UoM-AAS-CanSat-2023-24/FLIGHT_HARDWARE_2025/Graphics/mind-the-gap.jpg

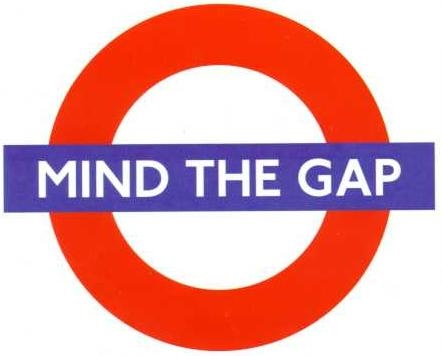
Graphics/mind-the-gap.jpg
