UoM-AAS-CanSat-2023-24/FLIGHT_HARDWARE_2025/Graphics/fry/LFT8uoP.jpeg

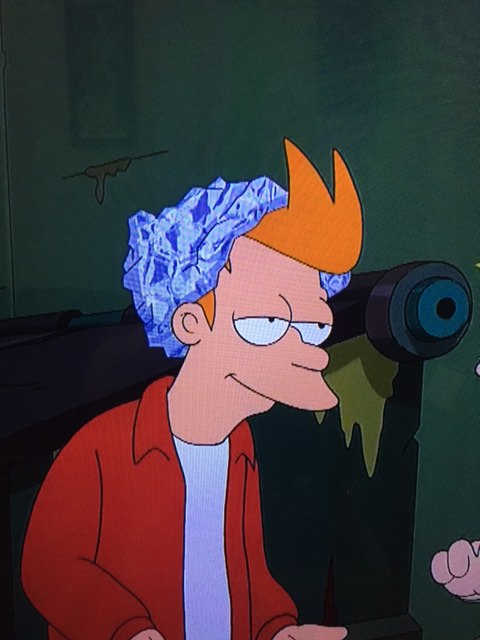
Graphics/fry/LFT8uoP.jpeg
