UoM-AAS-CanSat-2023-24/FLIGHT_HARDWARE_2025/Graphics/cow.jpeg

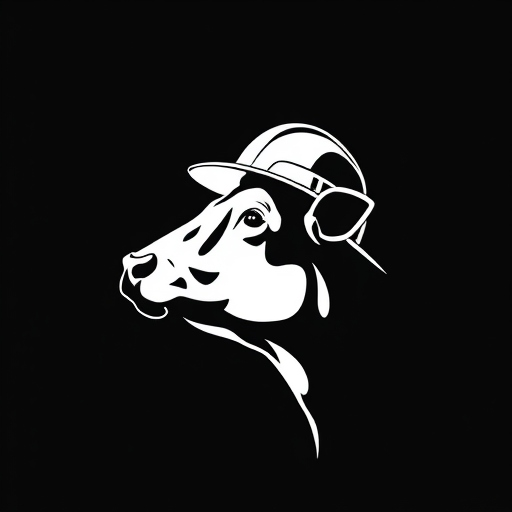
Graphics/cow.jpeg
