UoM-AAS-CanSat-2023-24/FLIGHT_HARDWARE_2025/Graphics/el_presidente.jpg

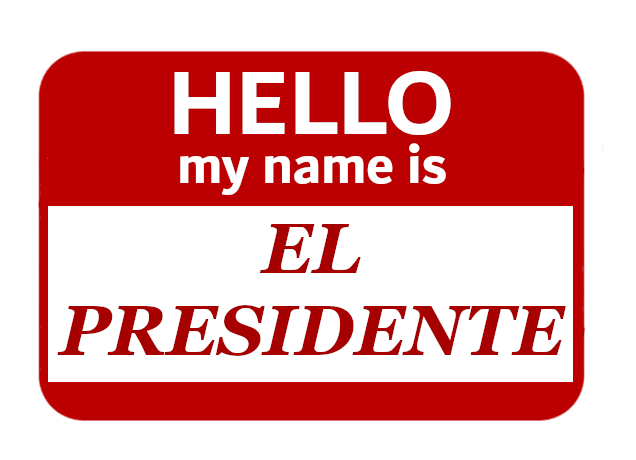
Graphics/el_presidente.jpg
