UoM-AAS-CanSat-2023-24/FLIGHT_HARDWARE_2025/Graphics/fry/hat.jpg

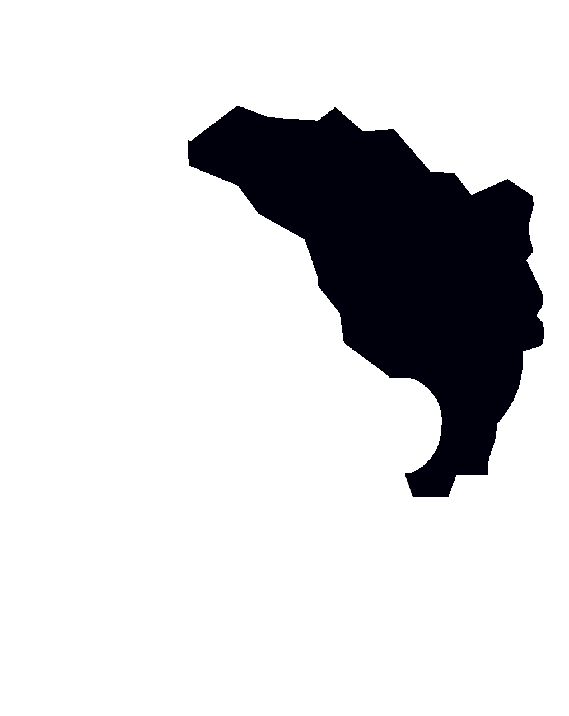
Graphics/fry/hat.jpg
