UoM-AAS-CanSat-2023-24/FLIGHT_HARDWARE_2025/Graphics/fry/hat_flipped.jpg

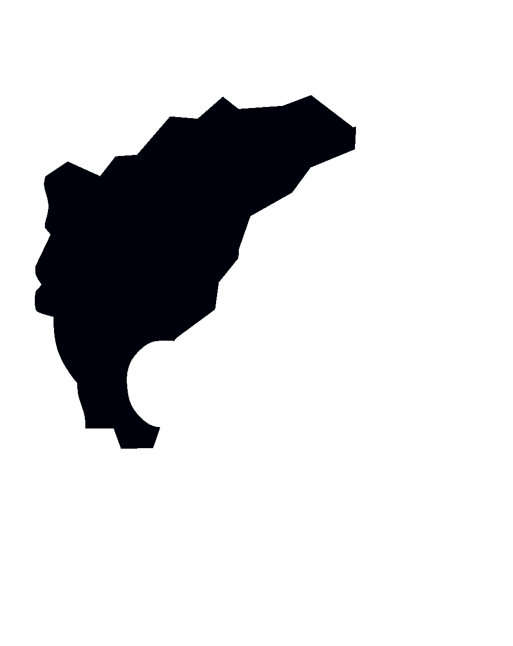
Graphics/fry/hat_flipped.jpg
