UoM-AAS-CanSat-2023-24/FLIGHT_HARDWARE_2025/Graphics/fry/outline_flipped.jpg

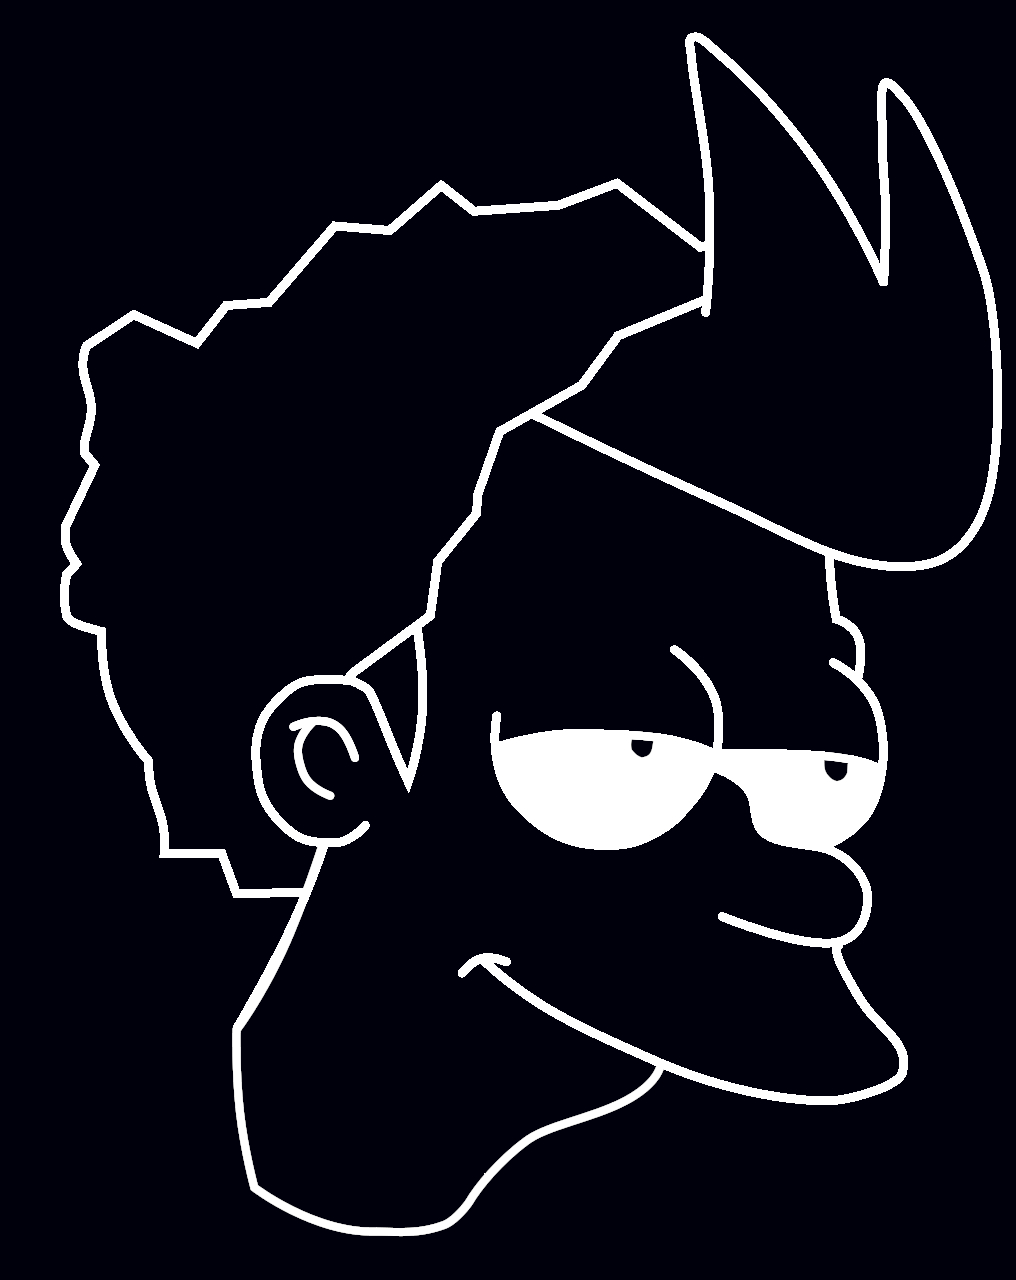
Graphics/fry/outline_flipped.jpg
