UoM-AAS-CanSat-2023-24/FLIGHT_HARDWARE_2025/Graphics/Ikea/ikea_screw.jpg

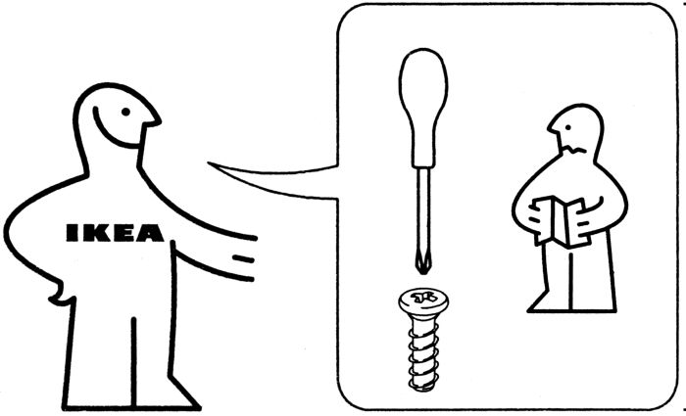
Graphics/Ikea/ikea_screw.jpg
