UoM-AAS-CanSat-2023-24/FLIGHT_HARDWARE_2025/Graphics/Ikea/man.jpg

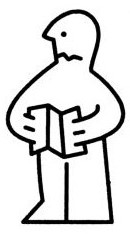
Graphics/Ikea/man.jpg
