UoM-AAS-CanSat-2023-24/FLIGHT_HARDWARE_2025/Graphics/M2269 UoM Bee graphic/UoM Bee 1 colour 50%black/UoM Bee 1 colour 50%black.png

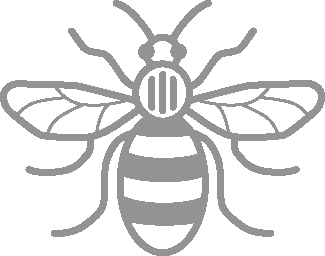
Graphics/M2269 UoM Bee graphic/UoM Bee 1 colour 50%black/UoM Bee 1 colour 50%black.png
