UoM-AAS-CanSat-2023-24/FLIGHT_HARDWARE_2025/Graphics/M2269 UoM Bee graphic/UoM Bee 1 colour white/UoM Bee 1 colour white.png

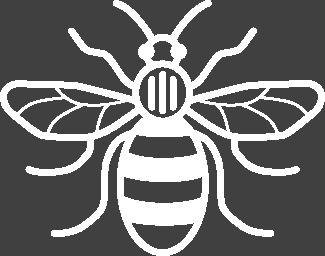
Graphics/M2269 UoM Bee graphic/UoM Bee 1 colour white/UoM Bee 1 colour white.png
