UoM-AAS-CanSat-2023-24/FLIGHT_HARDWARE_2025/Graphics/moses.jpeg

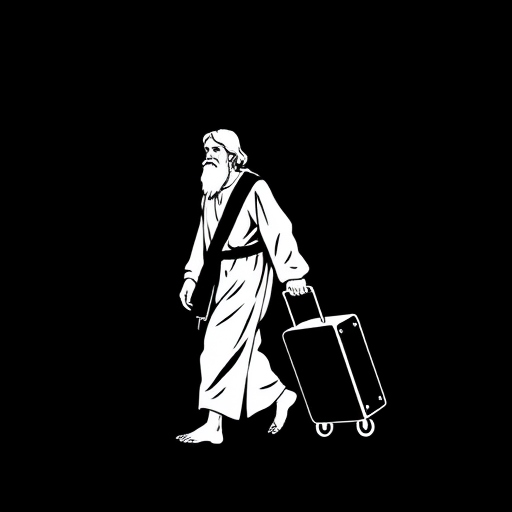
Graphics/moses.jpeg
