UoM-AAS-CanSat-2023-24/FLIGHT_HARDWARE_2025/Graphics/mugshot/option1_lens.jpg

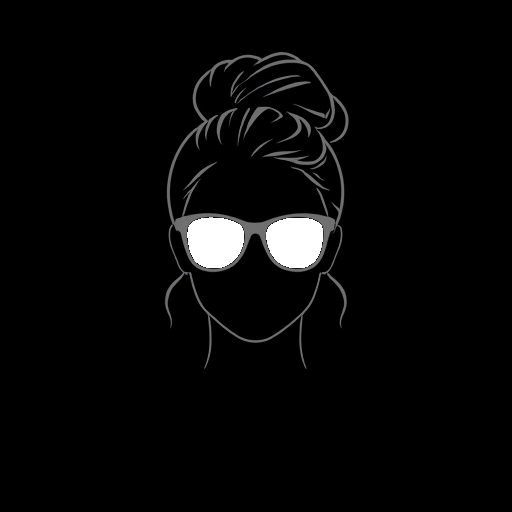
Graphics/mugshot/option1_lens.jpg
