UoM-AAS-CanSat-2023-24/FLIGHT_HARDWARE_2025/Graphics/name_tag.jpg

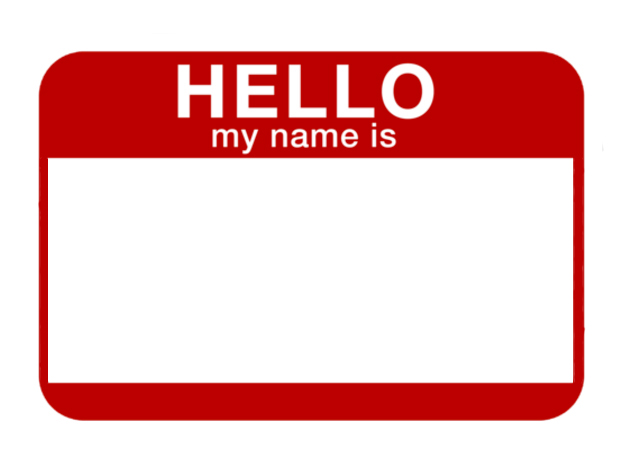
Graphics/name_tag.jpg
