UoM-AAS-CanSat-2023-24/FLIGHT_HARDWARE_2025/Graphics/Names_caps.png

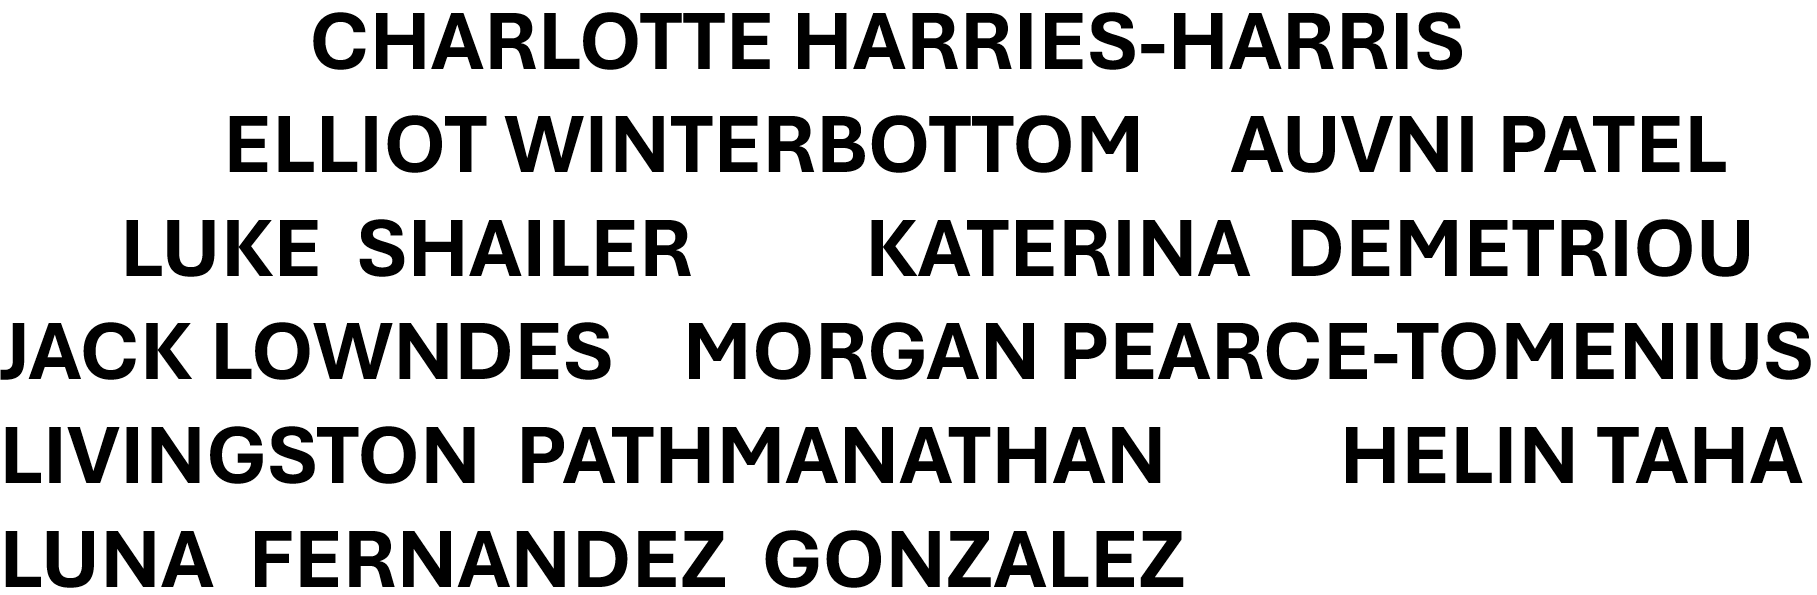
Graphics/Names_caps.png
