UoM-AAS-CanSat-2023-24/FLIGHT_HARDWARE_2025/Graphics/pepsi/6b5bf94c-5b68-4c5f-819d-e98600e77a42.jpeg

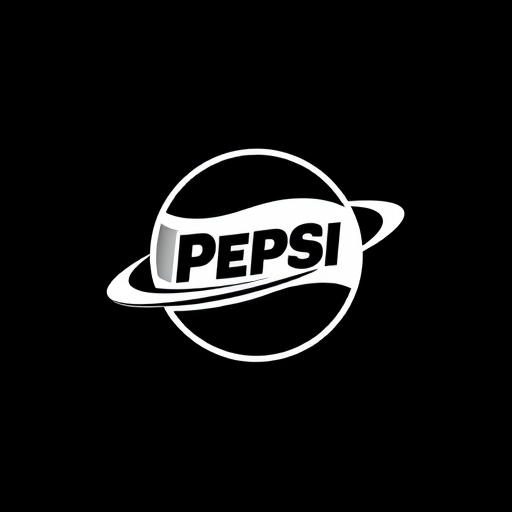
Graphics/pepsi/6b5bf94c-5b68-4c5f-819d-e98600e77a42.jpeg
