UoM-AAS-CanSat-2023-24/FLIGHT_HARDWARE_2025/Graphics/pepsi/pepsi_can.png

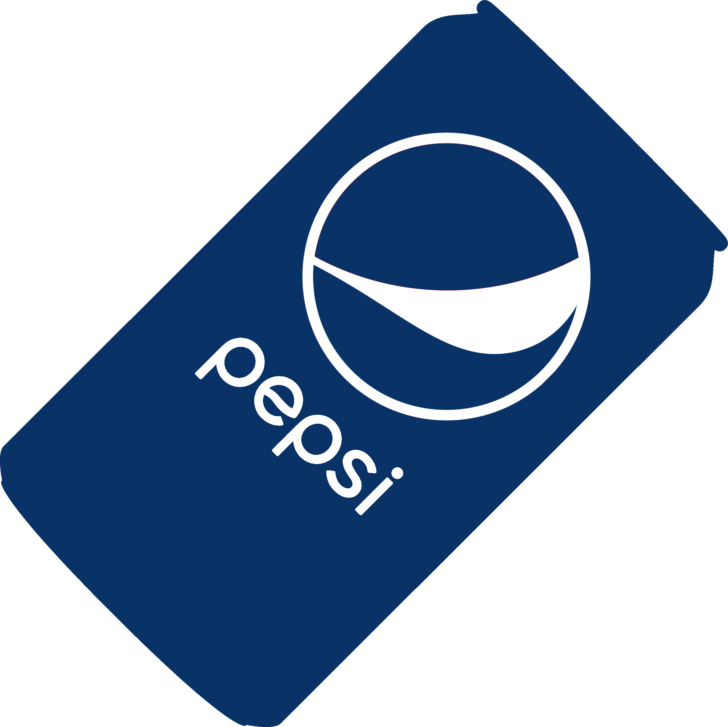
Graphics/pepsi/pepsi_can.png
