UoM-AAS-CanSat-2023-24/FLIGHT_HARDWARE_2025/Graphics/pepsi/pepsi_can_visible.png

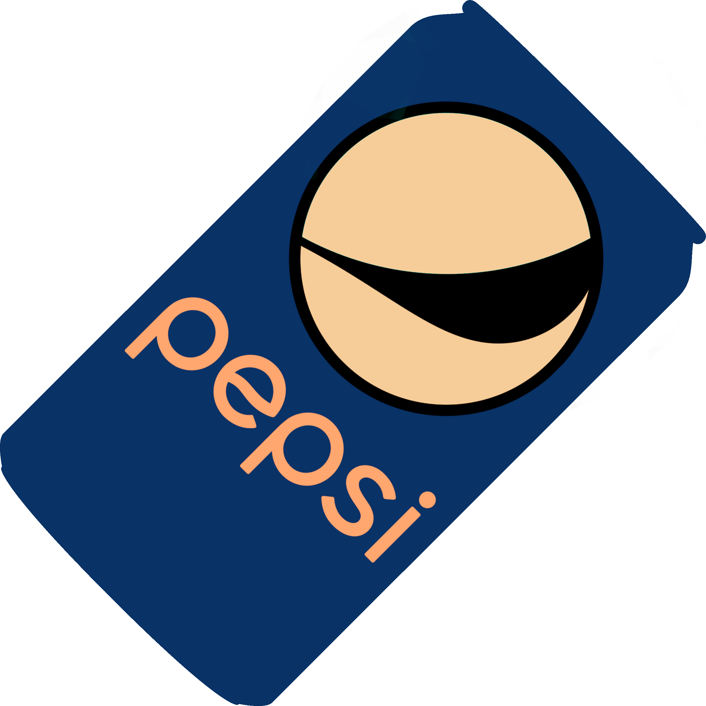
Graphics/pepsi/pepsi_can_visible.png
