UoM-AAS-CanSat-2023-24/FLIGHT_HARDWARE_2025/Graphics/rocket/4cc53620-2162-4fc7-a47f-79c95a0d47d6 (1).jpeg

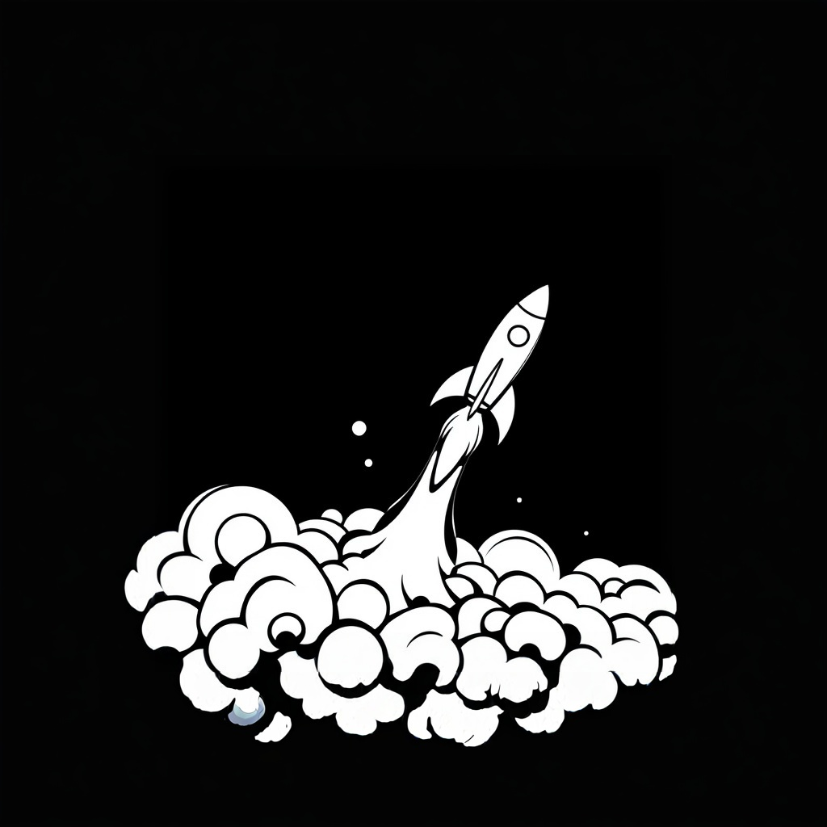
Graphics/rocket/4cc53620-2162-4fc7-a47f-79c95a0d47d6 (1).jpeg
