UoM-AAS-CanSat-2023-24/FLIGHT_HARDWARE_2025/Graphics/rocket/064fb599-cd3f-4d11-b22c-b6b6ec2b5fb0.jpeg

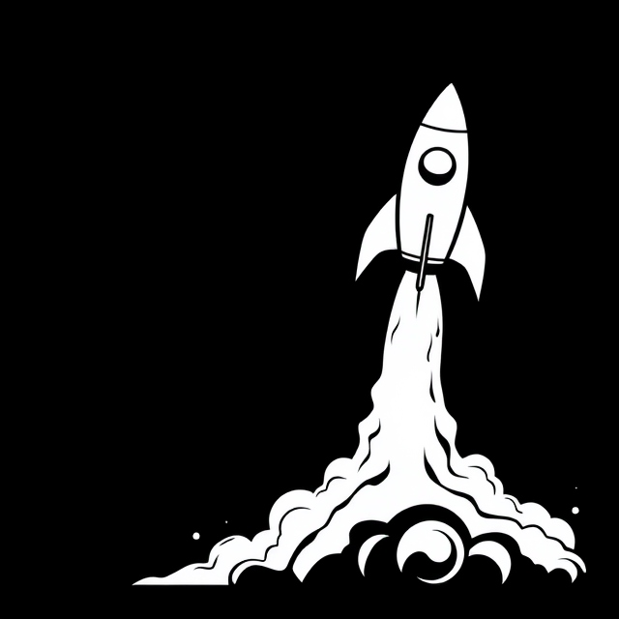
Graphics/rocket/064fb599-cd3f-4d11-b22c-b6b6ec2b5fb0.jpeg
