UoM-AAS-CanSat-2023-24/FLIGHT_HARDWARE_2025/Graphics/rocket/4742e43c-94d2-4249-8f20-79145a886548.jpeg

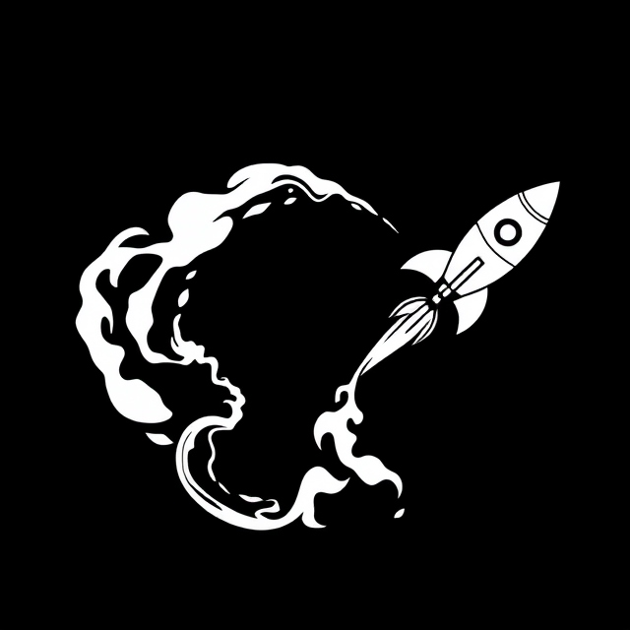
Graphics/rocket/4742e43c-94d2-4249-8f20-79145a886548.jpeg
