UoM-AAS-CanSat-2023-24/FLIGHT_HARDWARE_2025/Graphics/rocket/314970f9-b997-4553-ad8b-9b954e5c6598.jpeg

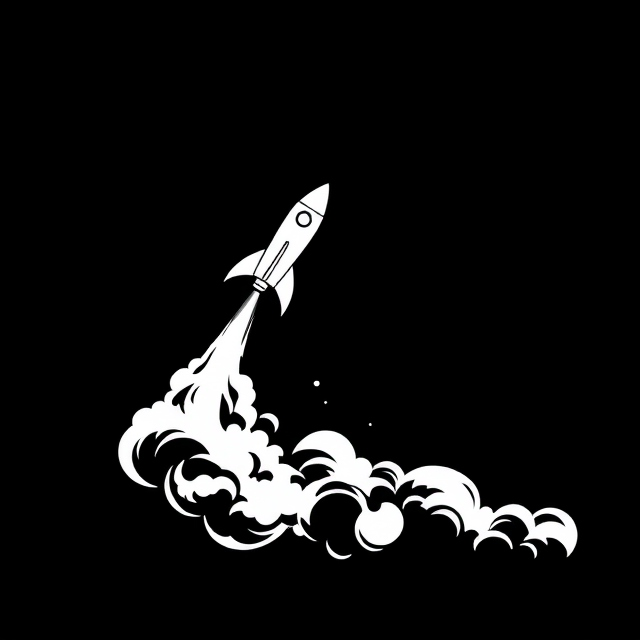
Graphics/rocket/314970f9-b997-4553-ad8b-9b954e5c6598.jpeg
