UoM-AAS-CanSat-2023-24/FLIGHT_HARDWARE_2025/Graphics/rocket/acd0356b-3580-4a97-9311-26d152e61aec.jpeg

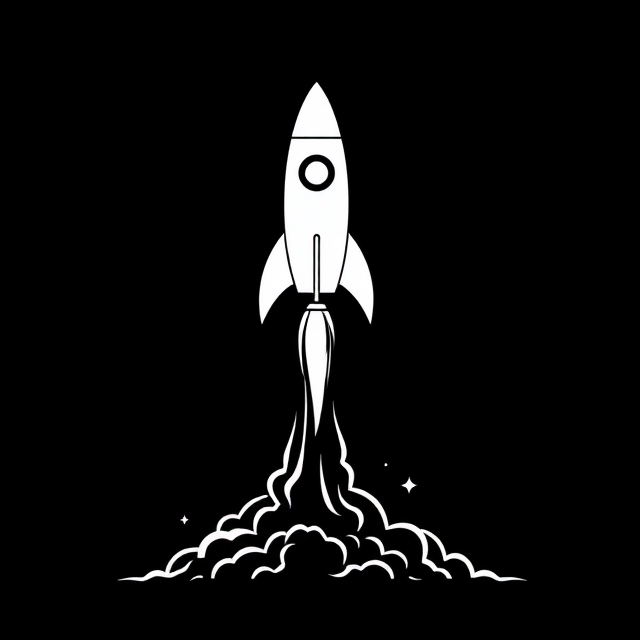
Graphics/rocket/acd0356b-3580-4a97-9311-26d152e61aec.jpeg
