UoM-AAS-CanSat-2023-24/FLIGHT_HARDWARE_2025/Graphics/rocket/isolated_exhaust.jpeg

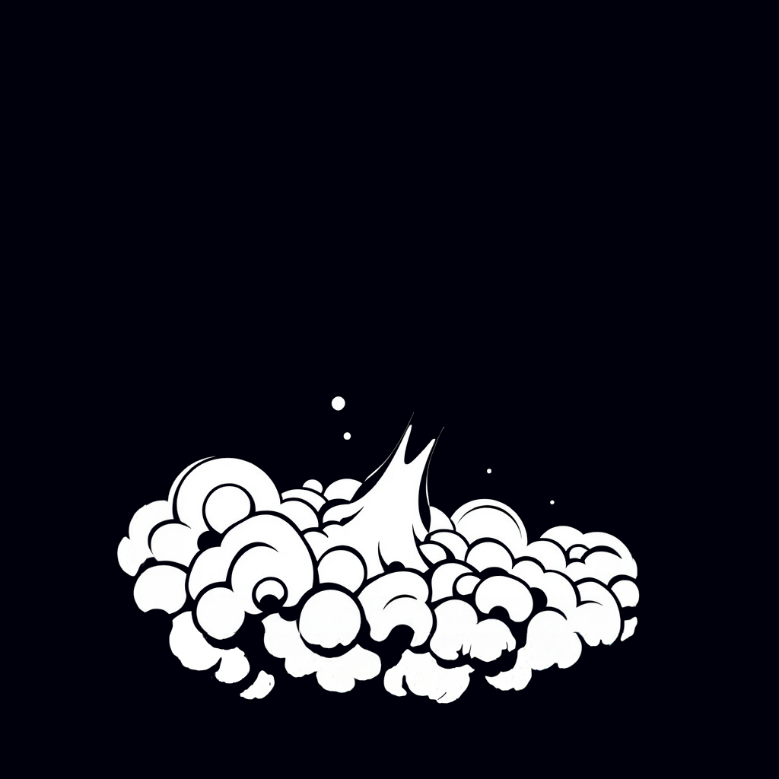
Graphics/rocket/isolated_exhaust.jpeg
