UoM-AAS-CanSat-2023-24/FLIGHT_HARDWARE_2025/Graphics/rocket/isolated_exhaust_5deg.jpeg

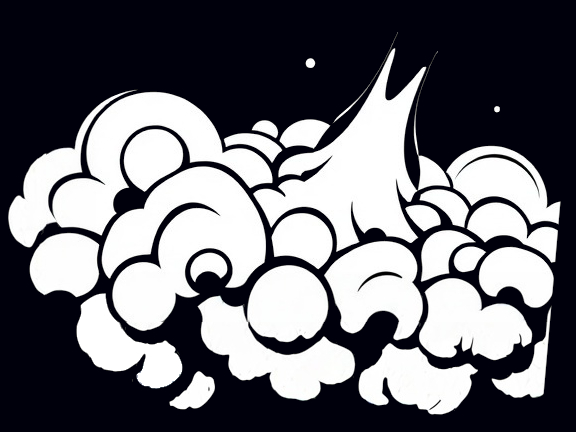
Graphics/rocket/isolated_exhaust_5deg.jpeg
