UoM-AAS-CanSat-2023-24/FLIGHT_HARDWARE_2025/Graphics/rocket/rocket_flame_5deg.jpeg

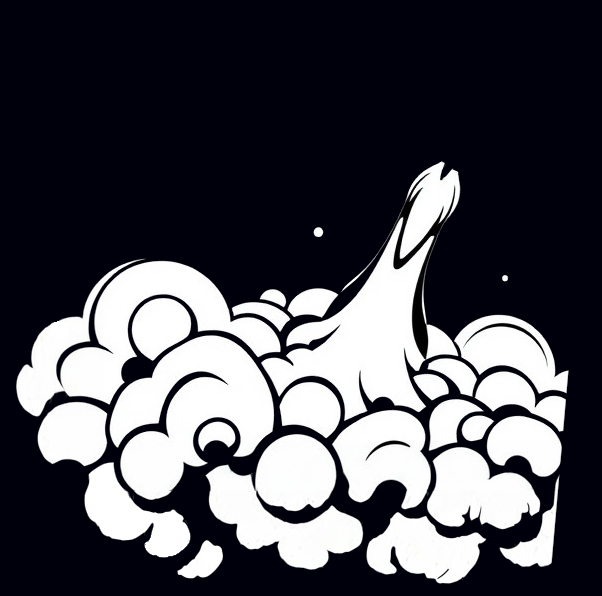
Graphics/rocket/rocket_flame_5deg.jpeg
