UoM-AAS-CanSat-2023-24/FLIGHT_HARDWARE_2025/Graphics/star_2.jpg

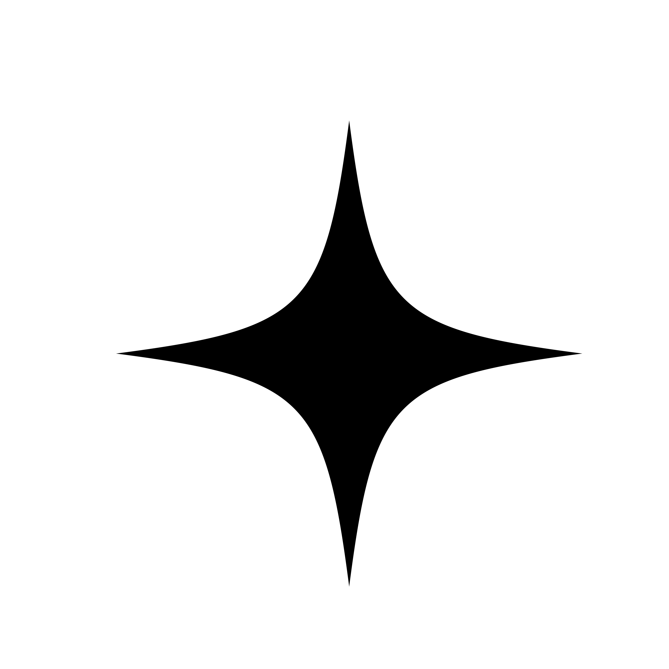
Graphics/star_2.jpg
