UoM-AAS-CanSat-2023-24/FLIGHT_HARDWARE_2025/Main Board/Gerbers/Main Board-Edge_Cuts_minus_teensy_slot.dxf

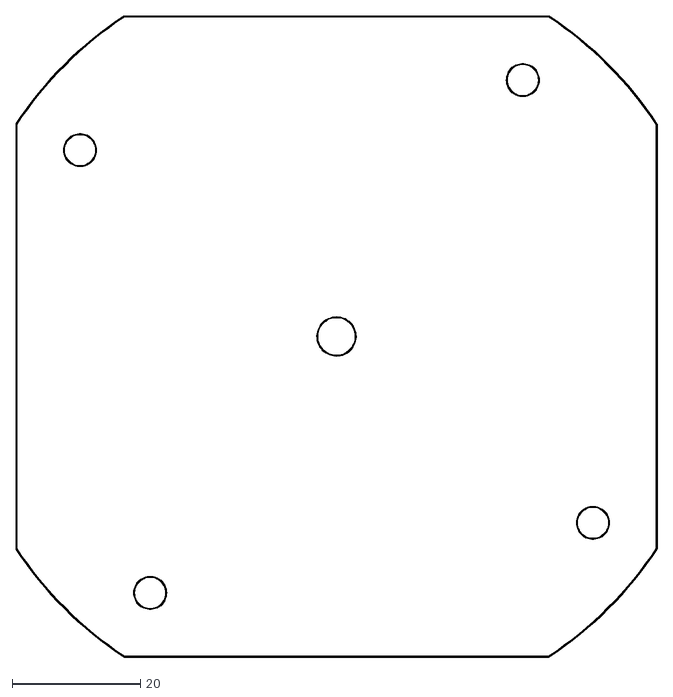
[picture p33: CAD file, 2025-07-16]
Main Board/Gerbers/Main Board-Edge_Cuts_minus_teensy_slot.dxf
100.1 x 100.1
