UoM-AAS-CanSat-2023-24/FLIGHT_HARDWARE_2025/Component Library/BMP581/3D/BMP581.stp

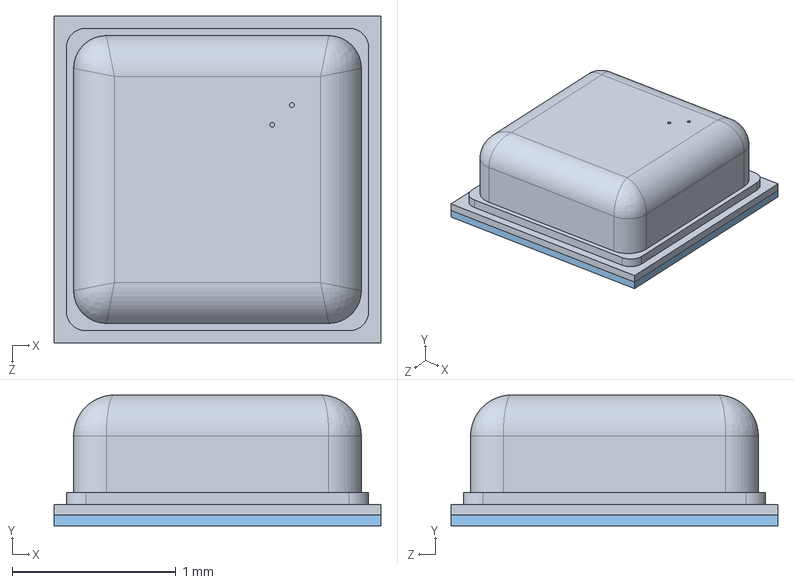
[picture p34: CAD file, 2025-07-16]
Component Library/BMP581/3D/BMP581.stp
2.00 x 0.801 x 2.00 mm
