UoM-AAS-CanSat-2023-24/FLIGHT_HARDWARE_2025/Component Library/Xbee/XBee.STEP

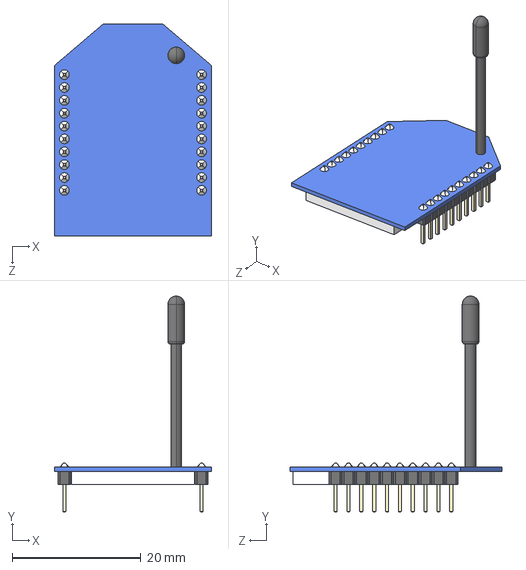
[picture p35: CAD file, 2025-07-16]
Component Library/Xbee/XBee.STEP
24.5 x 33.6 x 33.0 mm
