UoM-AAS-CanSat-2023-24/FLIGHT_HARDWARE_2025/screw_switch/screw_switch.step

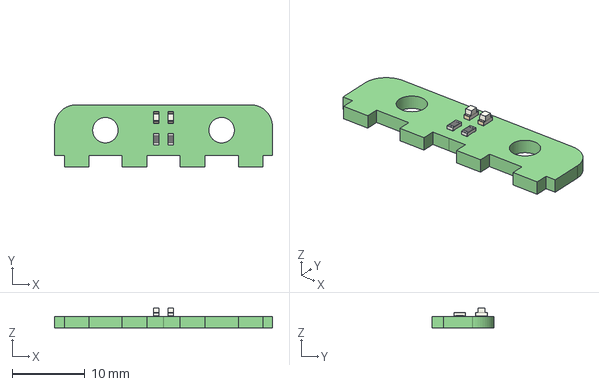
[picture p36: CAD file, 2025-07-16]
screw_switch/screw_switch.step
30.0 x 8.60 x 2.75 mm
screw_switch PCB
