UoM-AAS-CanSat-2023-24/FLIGHT_HARDWARE_2025/(list of files, cad)

Other CAD files:
Component Library/BMP581/Allegro/bmp581.psm
Component Library/BMP581/DEHDL/bmp581/chips/chips.prt
Component Library/Xbee/XBee.SLDPRT
Component Library/Xbee/XBee.stl
