UoM-AAS-CanSat-2023-24/FLIGHT_HARDWARE_2025/Main Board/Plots/Main Board-Actuators.pdf

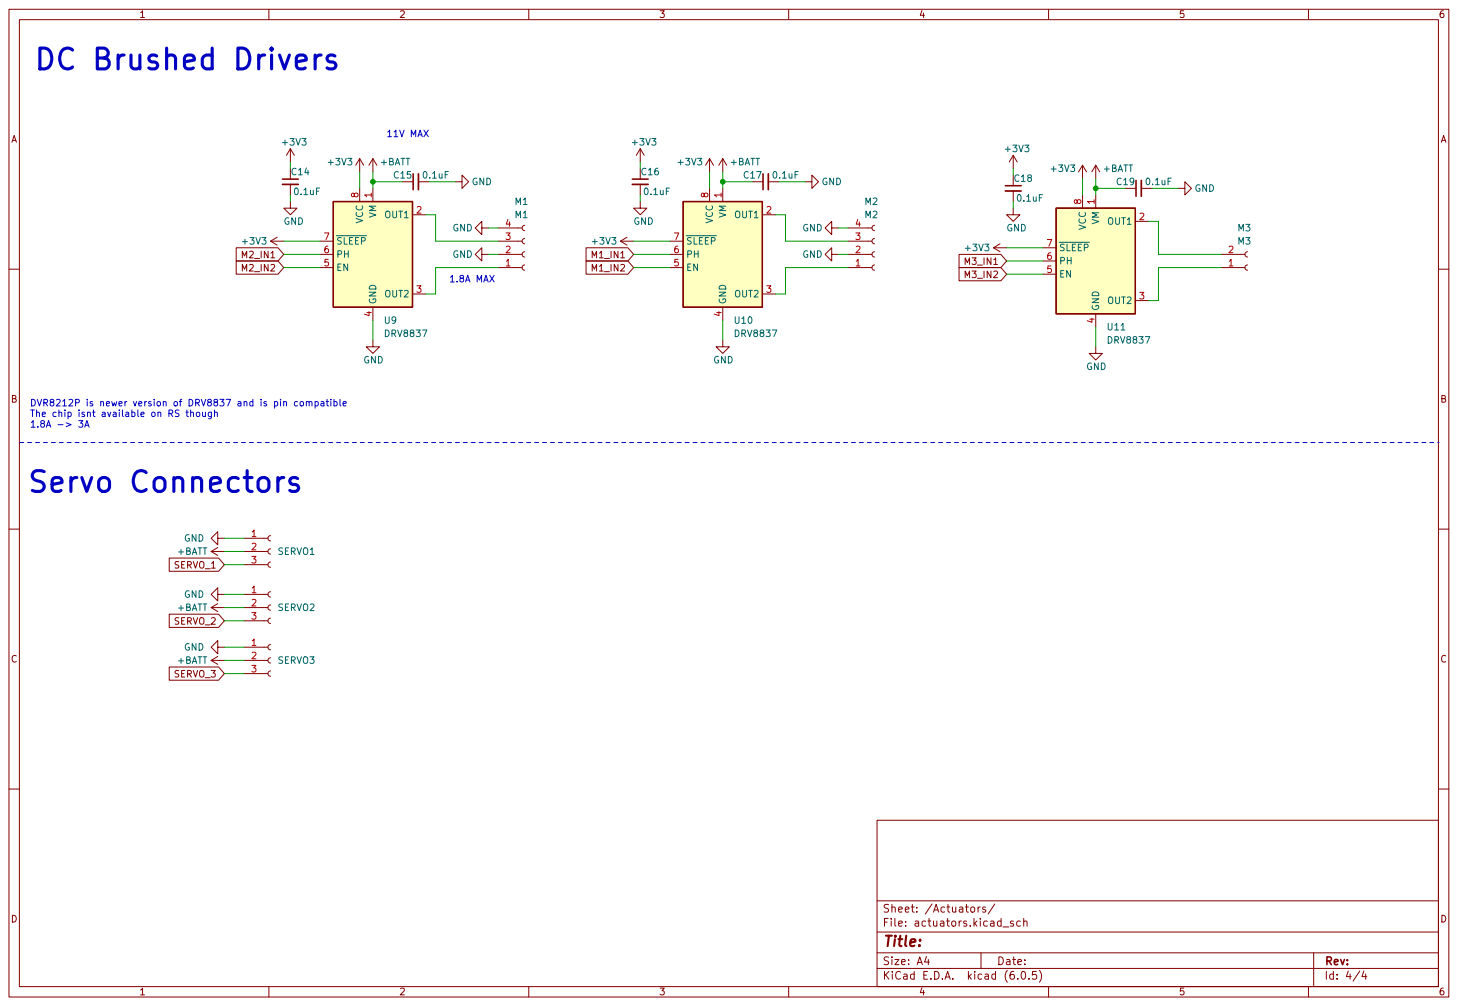
[picture p37: page 1]

4 EN 5 PH 6 ~{SLEEP} 7 VCC

DVR8212P is newer version of DRV8837 and is pin compatible
The chip isnt available on RS though

File: actuators.kicad_sch Sheet: /Actuators/
Id: 4/4 Title:
