UoM-AAS-CanSat-2023-24/FLIGHT_HARDWARE_2025/Main Board/Plots/Main Board-Sensors.pdf

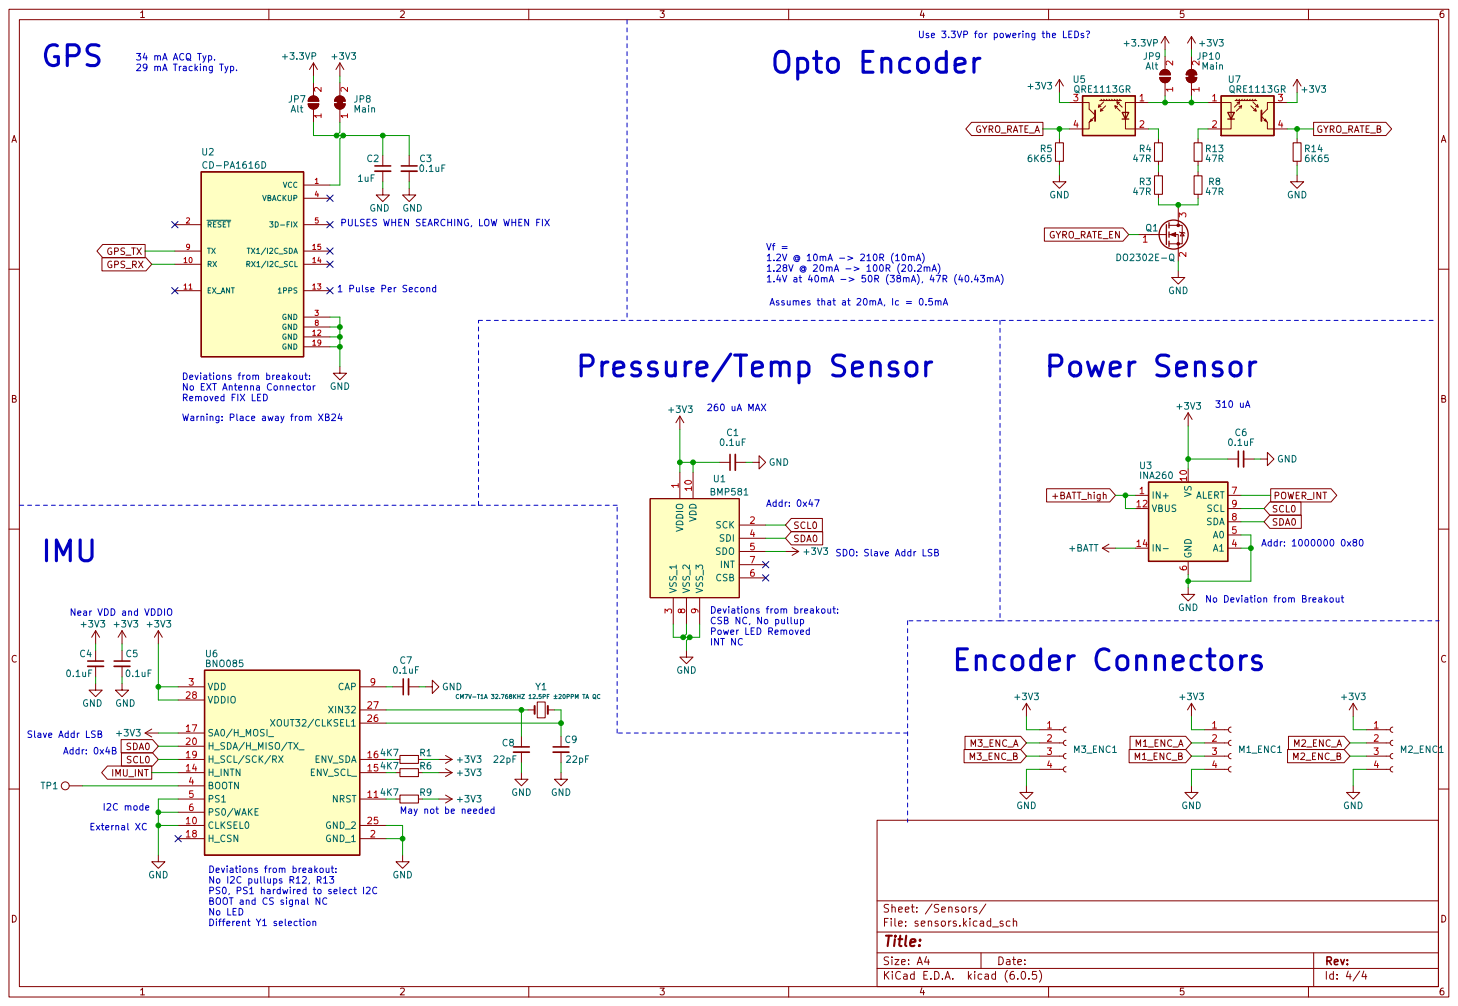
[picture p38: page 1]

GND
PULSES WHEN SEARCHING, LOW WHEN FIX

1.4V at 40mA -> 50R (38mA), 47R (40.43mA) 260 uA MAX Deviations from breakout: No EXT Antenna Connector Removed FIX LED

Assumes that at 20mA, Ic = 0.5mA

No Deviation from Breakout Encoder Connectors

File: sensors.kicad_sch Sheet: /Sensors/ GND

May not be needed

Deviations from breakout: No I2C pullups R12, R13 PS0, PS1 hardwired to select I2C

BOOT and CS signal NC
No LED
