UoM-AAS-CanSat-2023-24/FLIGHT_HARDWARE_2025/Main Board/Plots/Main Board.pdf

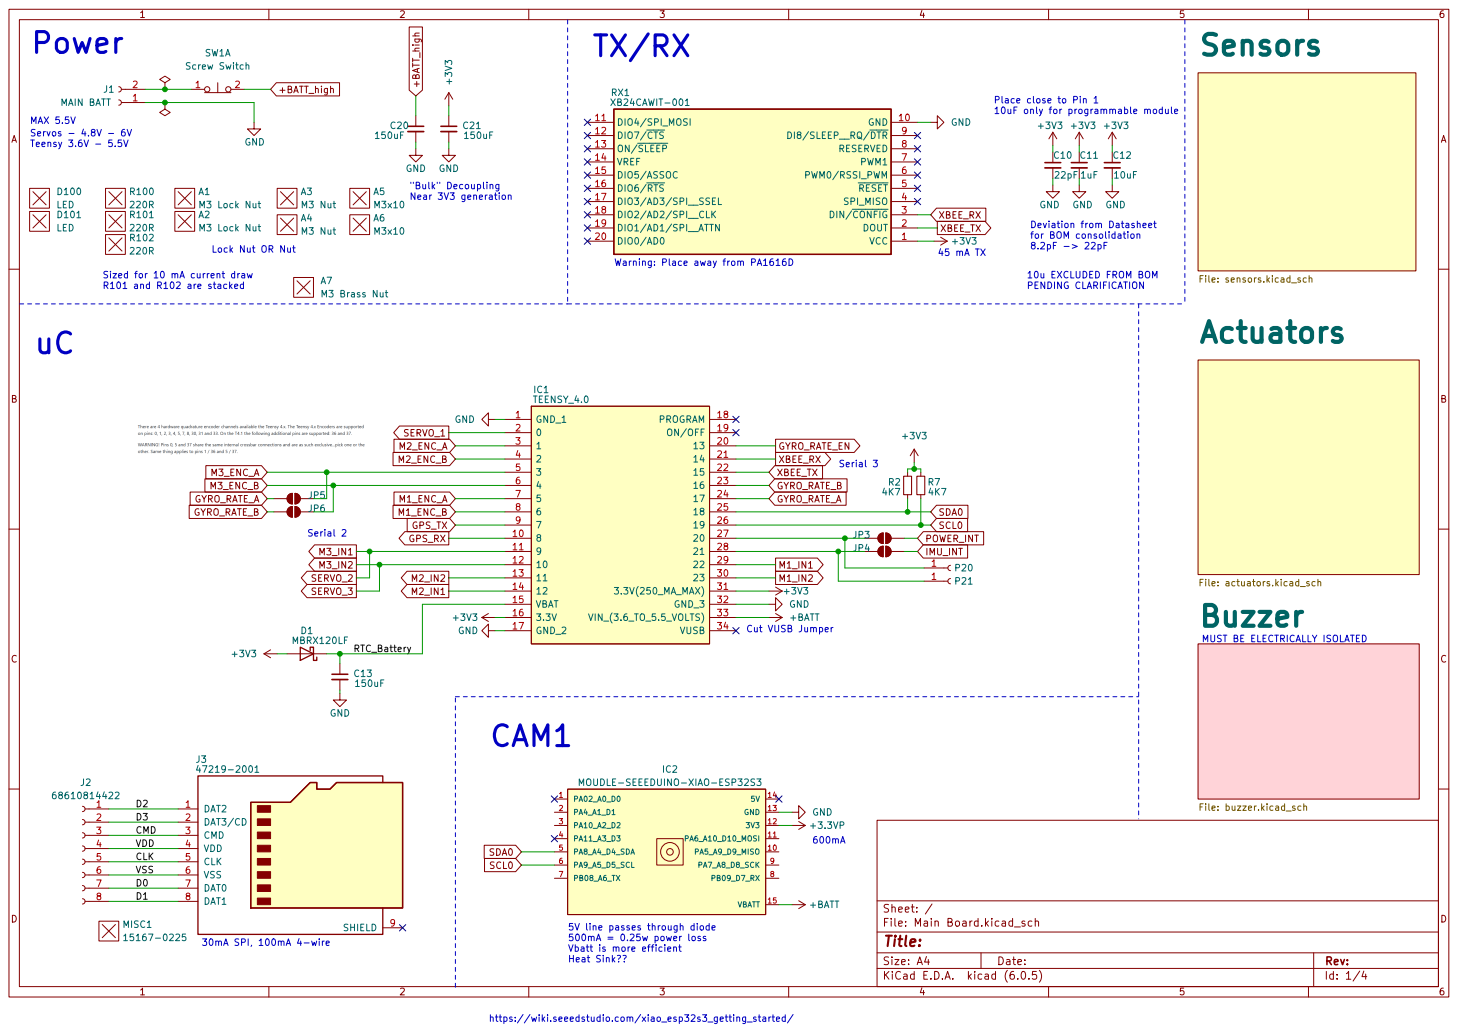
[picture p39: page 1]

Place close to Pin 1
10uF only for programmable module

8.2pF -> 22pF Lock Nut OR Nut

Warning: Place away from PA1616D

10u EXCLUDED FROM BOM PENDING CLARIFICATION

5V line passes through diode

https://wiki.seeedstudio.com/xiao_esp32s3_getting_started/
