UoM-AAS-CanSat-2023-24/FLIGHT_HARDWARE_2025/Graphics/M2269 UoM Bee graphic/M2269 UoM Bee.pdf

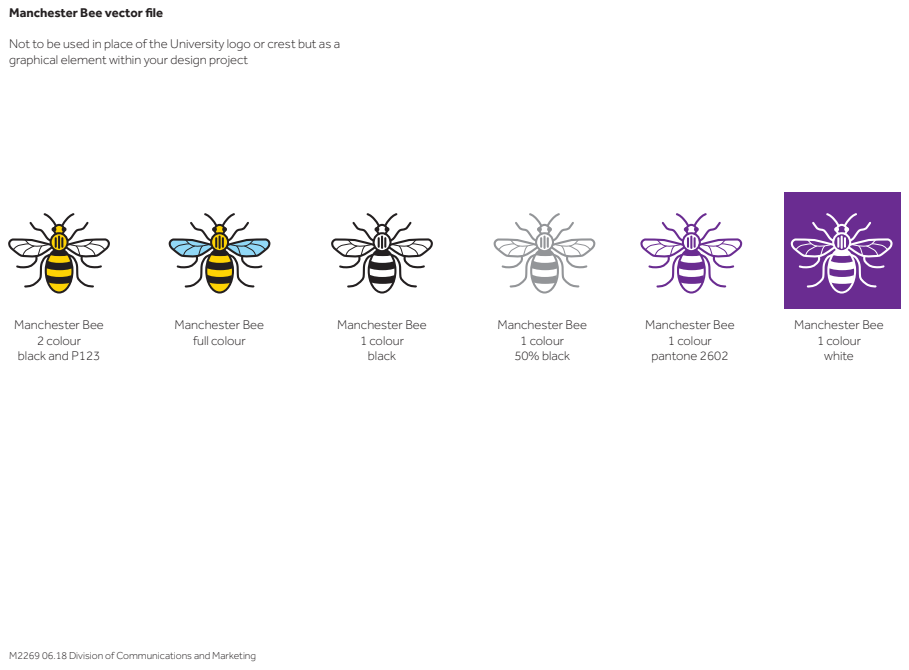
[picture p40: page 1]
Manchester Bee 2 colour black and P123; Manchester Bee full colour; Manchester Bee 1 colour black; Manchester Bee 1 colour 50% black; Manchester Bee 1 colour pantone 2602; Manchester Bee 1 colour white

Manchester Bee vector file

Not to be used in place of the University logo or crest but as a
graphical element within your design project

M2269 06.18 Division of Communications and Marketing
