UoM-AAS-CanSat-2023-24/FLIGHT_HARDWARE_2025/(list of files, drawings)

Other design files:
Component Library/BMP581/Altium/BMP581.PcbLib
Component Library/BMP581/Altium/BMP581.SchLib
