UoM-AAS-CanSat-2023-24/FLIGHT_HARDWARE_2025/Main Board/Main Board.kicad_pcb

## KiCad design Main Board/Main Board.kicad_pcb (2025-07-16)

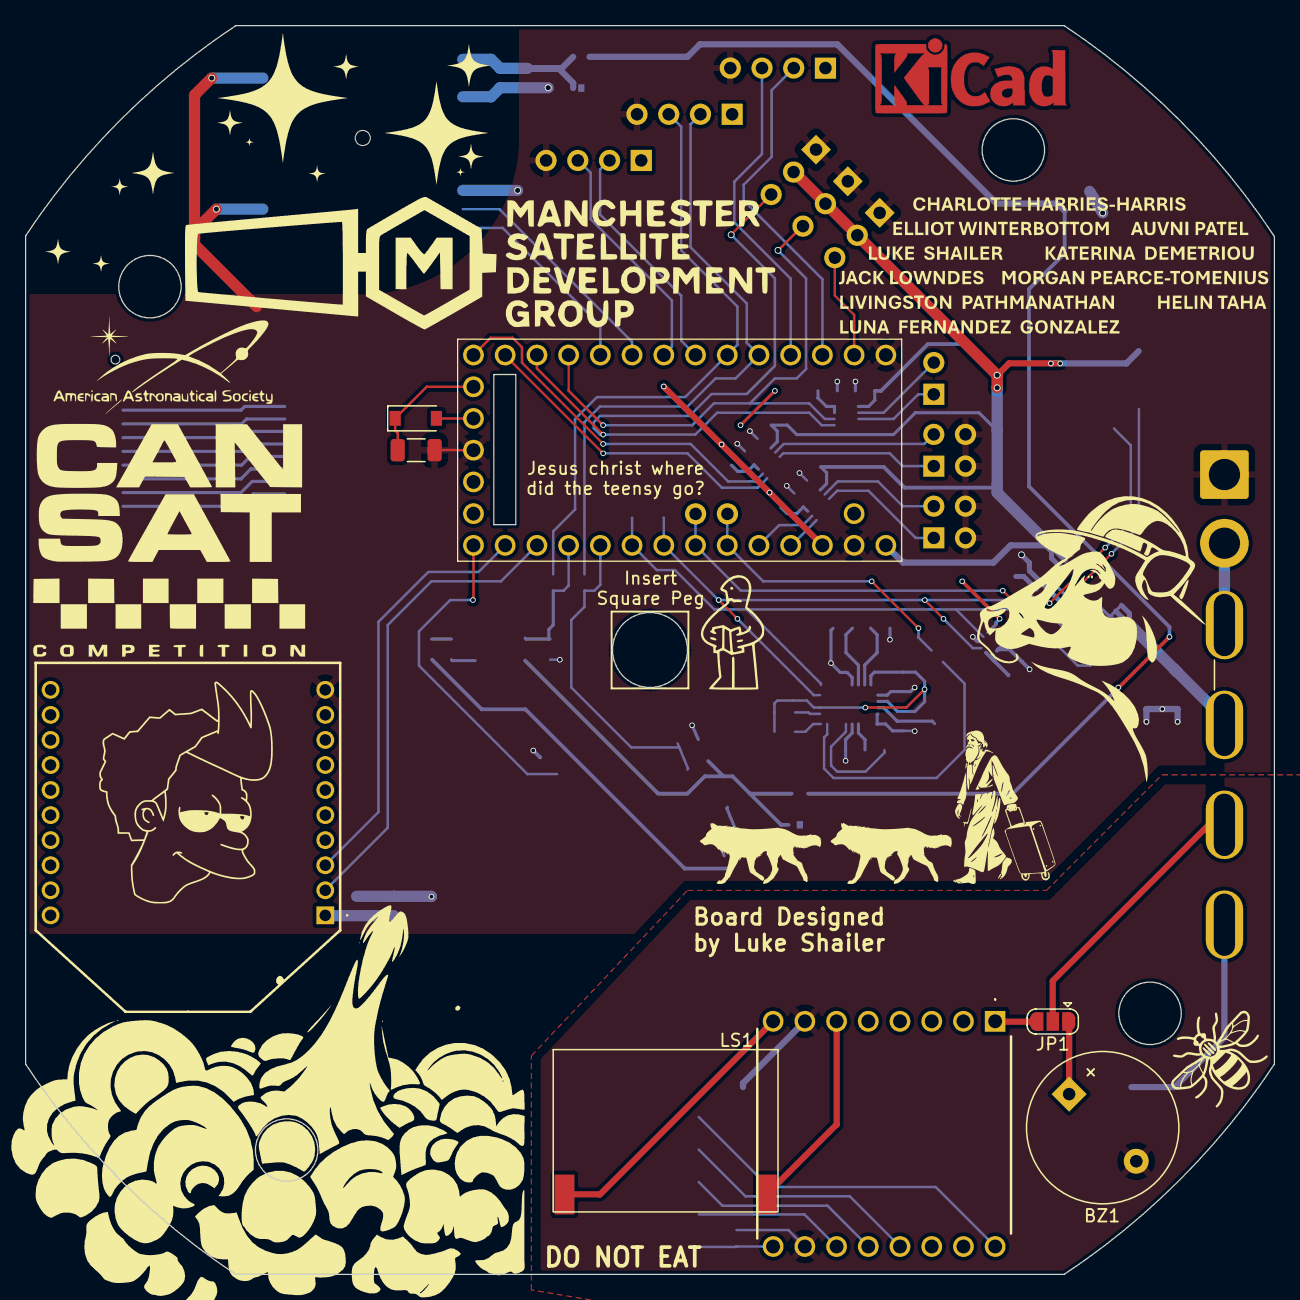
[picture p41: board Main Board.kicad_pcb from above]

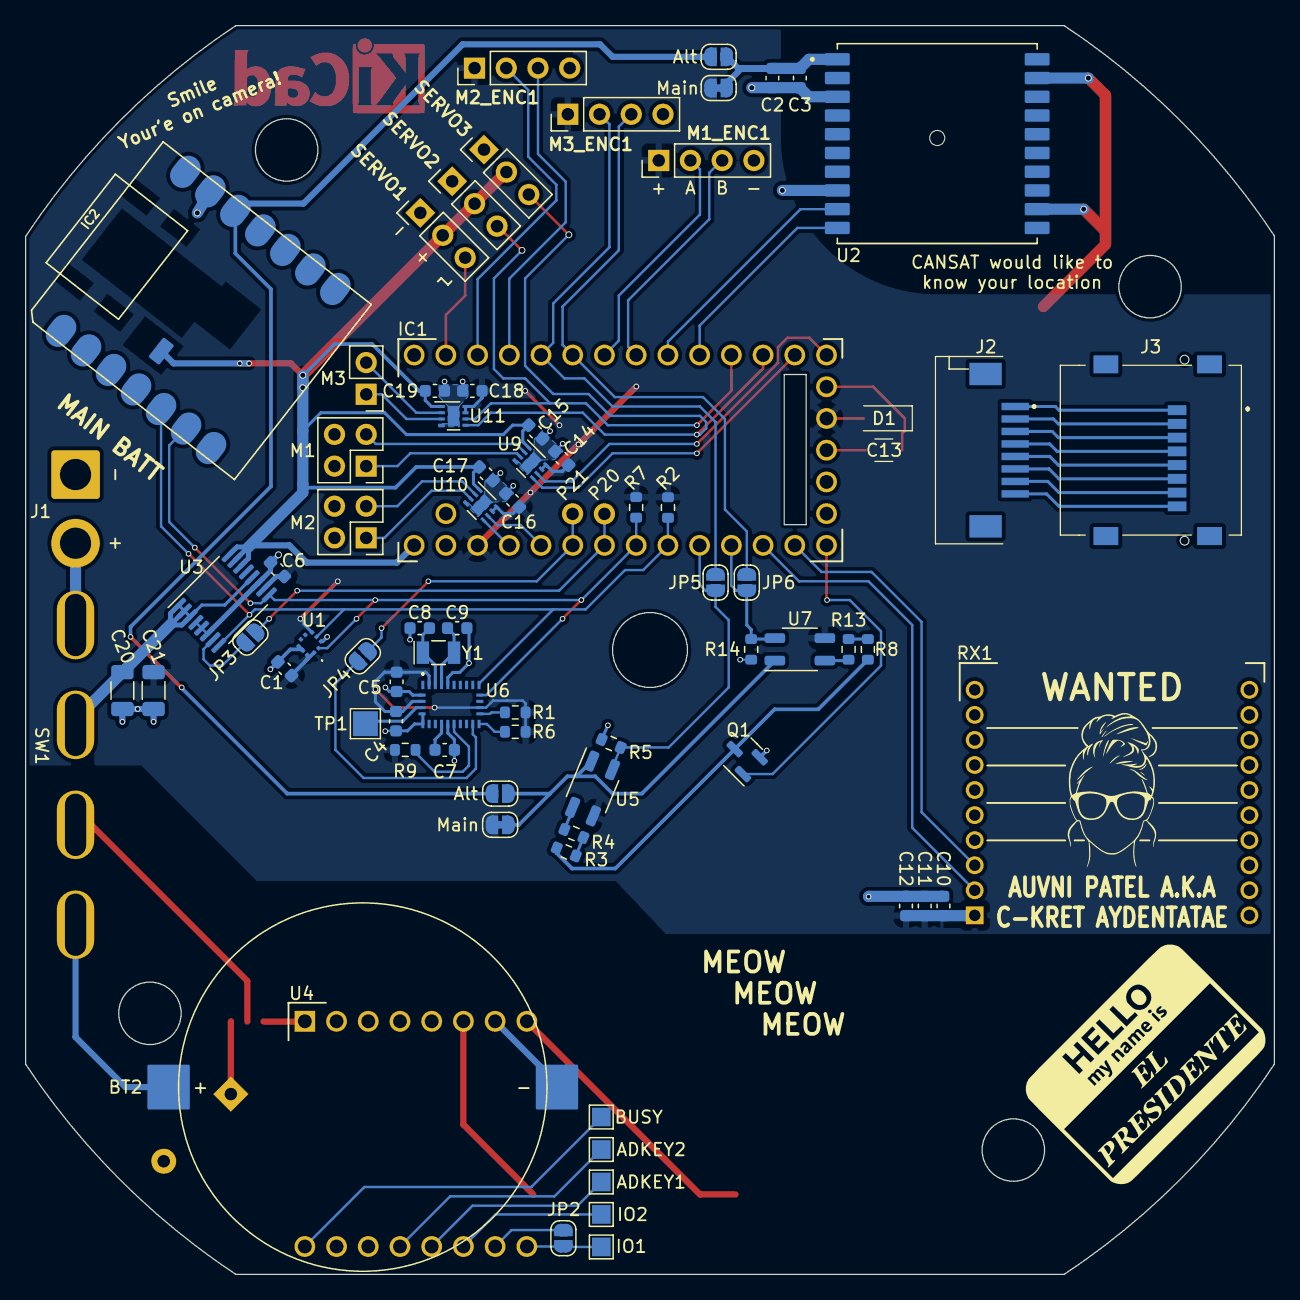
[picture p42: board Main Board.kicad_pcb from below]

Board: 2 copper layers, 100.0 x 100.0 mm, 82 parts (72 on the bottom side), 73 nets.

Parts:
BT2: CR2450 Battery Holder; 237-8264 Battery holder
BZ1: KXG1203C; Buzzer_12x9.5RM7.6
C1, C3, C4, C5, C6, C7, C14, C15, C16, C17, C18, C19: 0.1uF; C_0603_1608Metric
C2, C11: 1uF; C_0603_1608Metric
C8, C9, C10: 22pF; C_0603_1608Metric
C12: 10uF; C_0603_1608Metric
C13, C20, C21: 150uF; C_1206_3216Metric
D1: MBRX120LF; D_SOD-123
IC1: TEENSY_4.0; TEENSY40
IC2: MOUDLE-SEEEDUINO-XIAO-ESP32S3; MOUDLE14P-SMD-2.54-21X17.8MM
J1: MAIN BATT; SolderWire-2sqmm_1x02_P7.8mm_D2mm_OD3.9mm_Relief
J2: 68610814422
J3: 47219-2001; 472192001_wire_lock
J4: P20; PinHeader_1x01_P2.54mm_Vertical
J5: P21; PinHeader_1x01_P2.54mm_Vertical
JP1: SolderJumper_3_Open; SolderJumper-3_P1.3mm_Open_RoundedPad1.0x1.5mm
JP2, JP3, JP4, JP5, JP6: SolderJumper_2_Open; SolderJumper-2_P1.3mm_Open_RoundedPad1.0x1.5mm
JP7, JP9: Alt; SolderJumper-2_P1.3mm_Open_RoundedPad1.0x1.5mm
JP8, JP10: Main; SolderJumper-2_P1.3mm_Bridged_RoundedPad1.0x1.5mm
LS1: HDK-181308ZA-6P2; HDK-181308ZA-6P2 Speaker
M1: M1; PinHeader_2x02_P2.54mm_Vertical
M1_ENC1, M2_ENC1: M2_ENC; PinHeader_1x04_P2.54mm_Vertical
M2: M2; PinHeader_2x02_P2.54mm_Vertical
M3: M3; PinHeader_1x02_P2.54mm_Vertical
M3_ENC1: M1_ENC; PinHeader_1x04_P2.54mm_Vertical
Q1: DO2302E-Q; SOT-23
R1, R2, R6, R7, R9: 4K7; R_0603_1608Metric
R3, R4, R8, R13: 47R; R_0603_1608Metric
R5, R14: 6K65; R_0603_1608Metric
RX1: XB24CAWIT-001; XB24CAPIT001
SERVO1: Servo 2; PinHeader_1x03_P2.54mm_Vertical
SERVO2: Servo 1; PinHeader_1x03_P2.54mm_Vertical
SERVO3: Servo 3; PinHeader_1x03_P2.54mm_Vertical
SW1: Screw Switch; Board_Conn_CanSat
TP1: TestPoint; TestPoint_Pad_2.0x2.0mm
TP2: BUSY; TestPoint_Pad_1.5x1.5mm
TP3: ADKEY2; TestPoint_Pad_1.5x1.5mm
TP4: ADKEY1; TestPoint_Pad_1.5x1.5mm
TP5: IO2; TestPoint_Pad_1.5x1.5mm
TP6: IO1; TestPoint_Pad_1.5x1.5mm
U1: BMP581
U2: CD-PA1616D; PA1616D
U3: INA260; TSSOP-16_4.4x5mm_P0.65mm
U4: DFR0299
U5, U7: QRE1113GR; OnSemi_CASE100CY
U6: BNO085
U9, U10, U11: DRV8837; WSON-8-1EP_2x2mm_P0.5mm_EP0.9x1.6mm
Y1: CM7V-T1A 32.768KHZ 12.5PF ±20PPM TA QC; Crystal_SMD_MicroCrystal_CC7V-T1A-2Pin_3.2x1.5mm

Connections:
+3.3VP: IC2.12 (3V3), JP7.2 (B), JP9.2 (B)
+3V3: C1.1, C4.1, C5.1, C6.1, C10.1, C11.1, C12.1, C14.1, C16.1, C18.1, C21.1, D1.2 (A), IC1.16 (3.3V), IC1.31 (3.3V(250_MA_MAX)), JP8.2 (B), JP10.2 (B), M1_ENC1.1, M2_ENC1.1, M3_ENC1.1, R1.2, R2.2, R6.2, R7.2, R9.2, RX1.1 (VCC), U1.1 (VDDIO), U1.5 (SDO), U1.10 (VDD), U3.10 (VS), U5.3, U6.3 (VDD), U6.17 (SA0/H_MOSI_), U6.28 (VDDIO), U7.3, U9.7 (~SLEEP), U9.8 (VCC), U10.7 (~SLEEP), U10.8 (VCC), U11.7 (~SLEEP), U11.8 (VCC)
+BATT: C15.1, C17.1, C19.1, IC1.33 (VIN_(3.6_TO_5.5_VOLTS)), IC2.15 (VBATT), SERVO1.2, SERVO2.2, SERVO3.2, U3.14 (IN-), U3.15 (IN-), U3.16 (IN-), U9.1 (VM), U10.1 (VM), U11.1 (VM)
+BATT_high: C20.1, SW1.2, U3.1 (IN+), U3.2 (IN+), U3.3 (IN+), U3.12 (VBUS)
/Buzzer/Buzz_GND: BT2.2 (-), BZ1.2 (+), JP2.1 (A), U4.7 (GND_1), U4.10 (GND_2)
/CLK: J2.5, J3.5 (CLK)
/CMD: J2.3, J3.3 (CMD)
/D0: J2.7, J3.7 (DAT0)
/D1: J2.8, J3.8 (DAT1)
/D2: J2.1, J3.1 (DAT2)
/D3: J2.2, J3.2 (DAT3/CD)
/RTC_Battery: C13.1, D1.1 (K), IC1.15 (VBAT)
/VDD: J2.4, J3.4 (VDD)
/VSS: J2.6, J3.6 (VSS)
GND: C1.2, C2.2, C3.2, C4.2, C5.2, C6.2, C7.2, C8.2, C9.2, C10.2, C11.2, C12.2, C13.2, C14.2, C15.2, C16.2, C17.2, C18.2, C19.2, C20.2, C21.2, IC1.1 (GND_1), IC1.17 (GND_2), IC1.32 (GND_3), IC2.13 (GND), J1.1, M1.2, M1.4, M1_ENC1.4, M2.2, M2.4, M2_ENC1.4, M3_ENC1.4, Q1.2 (S), R5.1, R14.1, RX1.10 (GND), SERVO1.1, SERVO2.1, SERVO3.1, U1.3 (VSS_1), U1.8 (VSS_2), U1.9 (VSS_3), U2.3 (GND), U2.8 (GND), U2.12 (GND), U2.19 (GND), U3.4 (A1), U3.5 (A0), U3.6 (GND), U3.11 (GND), U6.2 (GND_1), U6.5 (PS1), U6.6 (PS0/WAKE), U6.10 (CLKSEL0), U6.25 (GND_2), U9.4 (GND), U9.9 (GND), U10.4 (GND), U10.9 (GND), U11.4 (GND), U11.9 (GND)
GPS_RX: IC1.10 (8), U2.10 (RX)
GPS_TX: IC1.9 (7), U2.9 (TX)
GYRO_RATE_A: IC1.24 (17), JP5.1 (A), R5.2, U5.4
GYRO_RATE_B: IC1.23 (16), JP6.1 (A), R14.2, U7.4
GYRO_RATE_EN: IC1.20 (13), Q1.1 (G)
IMU_INT: JP4.2 (B), U6.14 (H_INTN)
M1_ENC_A: IC1.7 (5), M1_ENC1.2
M1_ENC_B: IC1.8 (6), M1_ENC1.3
M1_IN1: IC1.29 (22), U10.6 (PH)
M1_IN2: IC1.30 (23), U10.5 (EN)
M2_ENC_A: IC1.3 (1), M2_ENC1.2
M2_ENC_B: IC1.4 (2), M2_ENC1.3
M2_IN1: IC1.14 (12), U9.6 (PH)
M2_IN2: IC1.13 (11), U9.5 (EN)
M3_ENC_A: IC1.5 (3), JP5.2 (B), M3_ENC1.2
M3_ENC_B: IC1.6 (4), JP6.2 (B), M3_ENC1.3
M3_IN1: IC1.11 (9), SERVO2.3, U11.6 (PH)
unnamed: BT2.1 (+), SW1.4 (2)
unnamed: BZ1.1 (-), JP1.1 (A)
unnamed: C7.1, U6.9 (CAP)
unnamed: C8.1, U6.27 (XIN32), Y1.1
unnamed: C9.1, U6.26 (XOUT32/CLKSEL1), Y1.2
unnamed: IC1.27 (20), J4.1, JP3.1 (A)
unnamed: IC1.28 (21), J5.1, JP4.1 (A)
unnamed: J1.2, SW1.1
unnamed: JP1.2 (C), SW1.3 (1)
unnamed: JP1.3 (B), U4.1 (VCC)
unnamed: LS1.1, U4.6 (SPK1)
unnamed: LS1.2, U4.8 (SPK2)
unnamed: M1.1, U9.3 (OUT2)
unnamed: M1.3, U9.2 (OUT1)
unnamed: M2.1, U10.3 (OUT2)
unnamed: M2.3, U10.2 (OUT1)
unnamed: M3.1, U11.3 (OUT2)
unnamed: M3.2, U11.2 (OUT1)
unnamed: Q1.3 (D), R3.1, R8.1
unnamed: R1.1, U6.16 (ENV_SDA)
unnamed: R3.2, R4.1
unnamed: R4.2, U5.2 (K)
unnamed: R6.1, U6.15 (ENV_SCL_)
unnamed: R8.2, R13.1
unnamed: R13.2, U7.2 (K)
unnamed: TP1.1, U6.4 (BOOTN)
unnamed: C2.1, C3.1, JP7.1 (A), JP8.1 (A), U2.1 (VCC)
unnamed: JP2.2 (B), TP6.1, U4.9 (IO1)
unnamed: TP5.1, U4.11 (IO2)
unnamed: TP4.1, U4.12 (ADKEY1)
unnamed: TP3.1, U4.13 (ADKEY2)
unnamed: TP2.1, U4.16 (BUSY)
unnamed: R9.1, U6.11 (NRST)
unnamed: JP9.1 (A), JP10.1 (A), U5.1 (A), U7.1 (A)
POWER_INT: JP3.2 (B), U3.7 (ALERT)
SCL0: IC1.26 (19), IC2.6 (PA9_A5_D5_SCL), R7.1, U1.2 (SCK), U3.9 (SCL), U6.19 (H_SCL/SCK/RX)
SDA0: IC1.25 (18), IC2.5 (PA8_A4_D4_SDA), R2.1, U1.4 (SDI), U3.8 (SDA), U6.20 (H_SDA/H_MISO/TX_)
SERVO_1: IC1.2 (0), SERVO1.3
SERVO_3: IC1.12 (10), SERVO3.3, U11.5 (EN)
XBEE_RX: IC1.21 (14), RX1.3 (DIN/~CONFIG)
XBEE_TX: IC1.22 (15), RX1.2 (DOUT)
