UoM-AAS-CanSat-2023-24/FLIGHT_HARDWARE_2025/(commit log)

2025-07-16 Add files via upload
    Add Main PCB kicad + gerber files. STEPs too large to add
    [Main Board-Edge_Cuts_minus_teensy_slot.dxf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]
2025-07-16 Add screw switch files via upload
    Add kicad, gerber, and step files for screw switch PCB
    [screw_switch-B_Cu.gbr, screw_switch-B_Mask.gbr, screw_switch-B_Paste.gbr, screw_switch-B_Silkscreen.gbr, screw_switch-Edge_Cuts.gbr, screw_switch-F_Cu.gbr, screw_switch-F_Mask.gbr, screw_switch-F_Paste.gbr]
